miguelalmeida2/G5-LIC2020-2021/(list of files, drawings)

Other design files:
LICLOGISIM/LICRouletteDisplay.circ
LICOrCAD/ISEL_LIB.OLB
LICORCAD/KeyBoard.opj
LICOrCAD/LIC.DSN
LICOrCAD/LIC.opj
