miguelalmeida2/G5-LIC2020-2021/(threads)

Thread 1 (2020-12-29):

falhas avaliação intercalar

tp323, 2020-12-29:
**version 1.2**
##  HARDWARE

**counter** 80/100
- [x] reduzir clocks para 3 em vez de 4 de forma a acelerar a máquina, não ter nenhum estado em que a máquina não está a verificar nenhuma coluna do teclado

**decoder** 80/100

**PENC** 25/100
- [x] foi estabelecido um encoder e não um priority encoder

**ASM Control** 50/100
- [x] Não foi implementado o FULL INTERLOCK

**CUPL Control** 100/100
A máquina de estados está corretamente implementada com base no nosso ASM CHART
- [x] refazer com base em novo ASM

**ASM KeyBuffer** 75/100
É como se o KeyBuffer não existisse na nossa implementação, pois o keyboard fica inativo atá o software retornar ACK
Com a implementação atual podíamos remover o KeyBuffere a máquina teria o mesmo comportamento
- [x] corrigir ASM de forma a não bloquear o teclado, guardando a input do KEYSTROKE

**CUPL KeyBuffer** 90/100
A máquina de estados tem alguns erros com base no nosso ASM CHART
- [x] refazer com base em novo ASM

**Esquema elétrico** 0/100
Não foi cotado por não ter sido englobado no  relatório, só itens englobados no relatório são cotados
- [x] corrigir ORCAD

## SOFTWARE

**HAL** 85/100
- [x] Estabelecer ligação entre HAL e KBD

**KBD** 30/100
- [x] Substituir Switch por Array
- [x] o protocolo do keyboard não é cumprido alterar de forma a correr de de acordo com o mesmo
- [x] keyboard waitkey não interage com o HAL

## DOCUMENTAÇÃO   50/100
Não foi apresentado nos formatos sugeridos DATA SHEET
Não permite a replicação do projeto na integra por não conter todas as componentes da execução do projeto, nomeadamente o esquema elétrico

Closed 2021-02-18.

Thread 2 (2020-12-30):

Ligação entre HAL e KBD

tp323, 2020-12-30:
HAL aparenta não comunicar corretamente com o USB.port
na simulação o USBport não funciona como seria de esperar, não reage às inputs que lhe são transmitidas
aparentam haver problemas nas operações lógicas bitwise no HAL

- [x] corrigir comunicação entre HAL e USB.port de forma a que este leia e reaja às inputs corretamente
- [x] corrigir problemas com operações lógicas bitwise no HAL
- [x] conseguir ler corretamente as teclas premidas no KBD através dos dados lidos pelo HAL

Closed 2021-01-05.

Thread 3 (2021-01-05):

BUG KBD

tp323, 2021-01-05:
Keyboard lê corretamente primeira input.
Mas todas as seguintes inputs só são lidas após outra tecla ser pressionada, apresentando sempre a tecla anterior à que pressionamos.
o problema é no KBD, pois a HAL está a transmitir corretamente os bits de entrada correspondentes ao KBD simulado

tp323, 2021-01-06:
fixed

Closed 2021-01-06.
