miguelalmeida2/G5-LIC2020-2021/(commit log)

2020-12-29 update
    Added CUPL files
    +Key Control
    +Key Decode
    +Key Buffer
    +RouletteDisplay
    +
    Added Logisim file
    +LICRouletteDisplay
    Added LICORCAD folder and file
    +KeyBoard
    Added LICREPORTS folder
    [KeyBoard.opj, LICRouletteDisplay.circ]
2021-01-02 1.3fixCounter
    fix counter form 4 clocks to 3
    [LICRouletteDisplay.circ]
2021-01-03 1.3fixPENC
    fixed PENC by adding priority to the Encoder
    PENC currently implemented as a PENC Priority Low
    [LICRouletteDisplay.circ]
2021-01-03 1.3
    changes to software
    [LICRouletteDisplay.circ]
2021-01-08 2.1
    Maintainance fully implemented
    BUGS
    Problems with get into and out off maintainance related with button M
2021-01-10 OrCad - Versão 2
    Pronto para Avaliação Intercalar
    [ISEL_LIB.OLB, LIC.DSN, LIC.opj]
2021-01-10 Orcad 2.1
    Melhoramento no aspecto do esquemático
    [LIC.DSN, LIC.opj]
2021-01-20 LIC.opj , Contrast set to GND and change in CoinAcceptor
    Small Change done to Schematic and CoinAcceptor.java
    [LIC.DSN, LIC.opj]
2021-01-22 UPDATE AULA PRÁTICA
    [LIC.opj]
2021-01-28 6.0
    - Virtualized M
    - added main class to HAL, KBD, LCD
    - turned hardcoded values in LCD to finals vars
    [LICRouletteDisplay.circ]
2021-02-06 updates
    logisim
    [LICRouletteDisplay.circ]
2021-02-07 Small update
    [LICRouletteDisplay.circ]
2021-02-07 Serial Receiver fixed in LOGI
    [LICRouletteDisplay.circ]
2021-02-07 RD - Serial Interface added
    [LICRouletteDisplay.circ]
2021-02-07 Serial Emitter fixed
    [LICRouletteDisplay.circ]
2021-02-07 Orcad Changes GND and VDD
    [LIC.DSN, LIC.opj]
2021-02-07 Serial Interface completed
    [LICRouletteDisplay.circ]
